pierpaolo452/Dynamic-DC-eLoad/README.md

# Dynamic DC eLoad
A DC electronic load with protections. It's a learning/developing project, so a lot of things are discrete just for learning to build it for example the Efuse is discrete
