pierpaolo452/Dynamic-DC-eLoad/Simulations/PID/PID.png

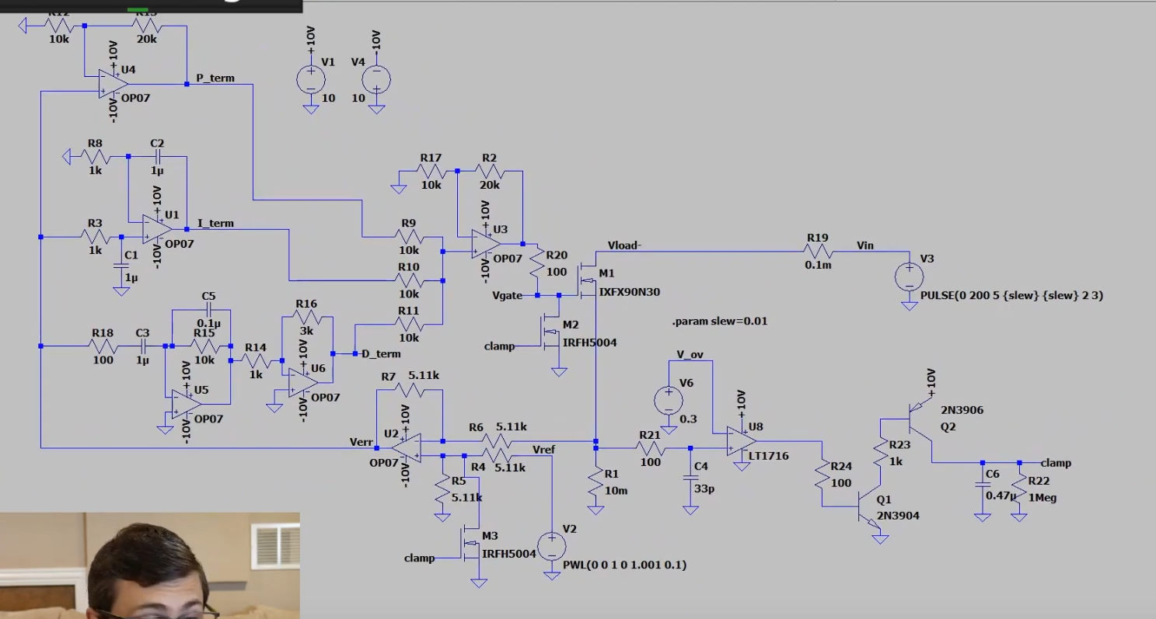
Simulations/PID/PID.png
