pierpaolo452/Dynamic-DC-eLoad/PCB/ADS131M04IPWR/ADS131M04IPWR.step

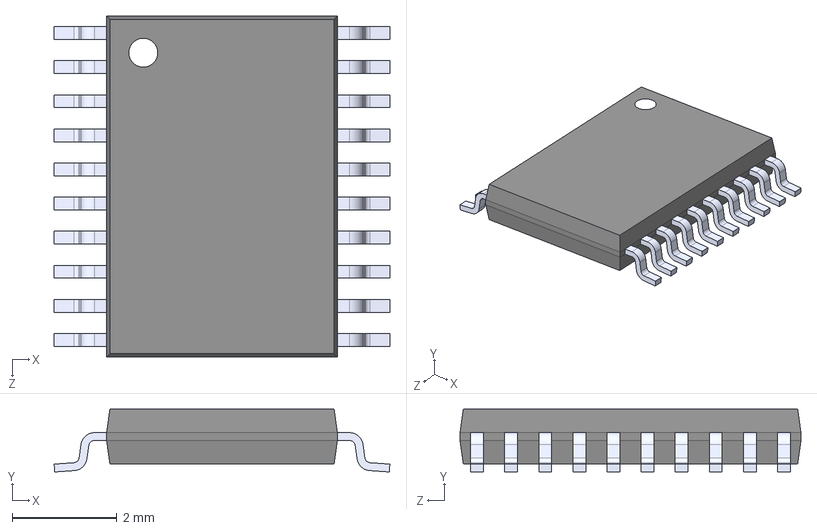
[picture p2: CAD file, 2025-09-29]
PCB/ADS131M04IPWR/ADS131M04IPWR.step
6.40 x 1.20 x 6.50 mm
