pierpaolo452/Dynamic-DC-eLoad/PCB/DAC8830IDR/DAC8830IDR.step

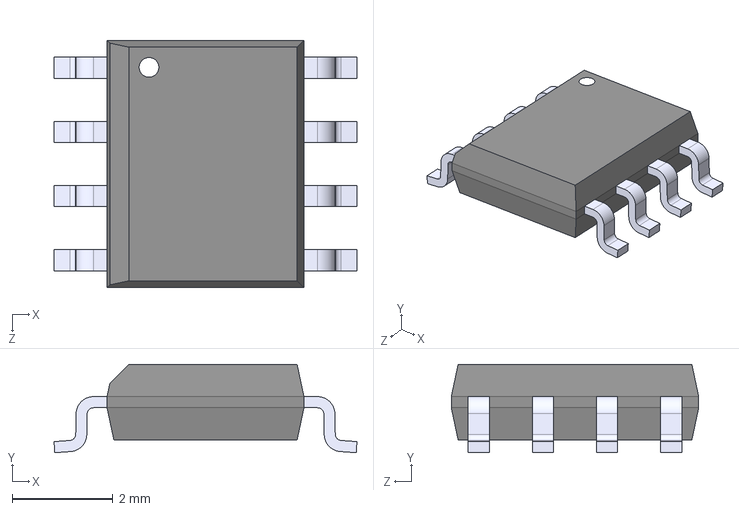
[picture p3: CAD file, 2025-09-29]
PCB/DAC8830IDR/DAC8830IDR.step
6.00 x 1.75 x 4.90 mm
