pierpaolo452/Dynamic-DC-eLoad/PCB/IRFP250N/IRFP250N.step

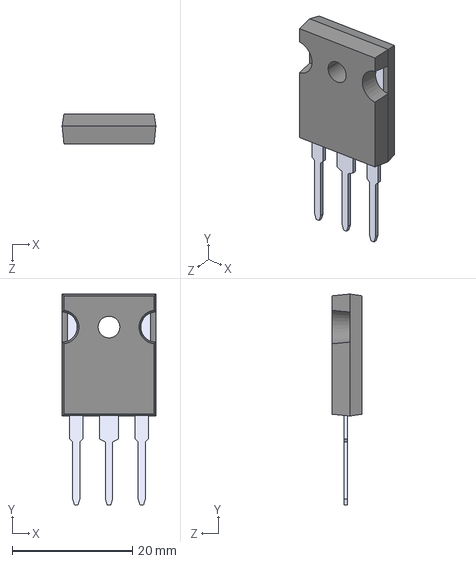
[picture p4: CAD file, 2025-09-29]
PCB/IRFP250N/IRFP250N.step
15.6 x 35.1 x 5.00 mm
