pierpaolo452/Dynamic-DC-eLoad/PCB/rotary encoder/PEC11R-4215F-S0024.step

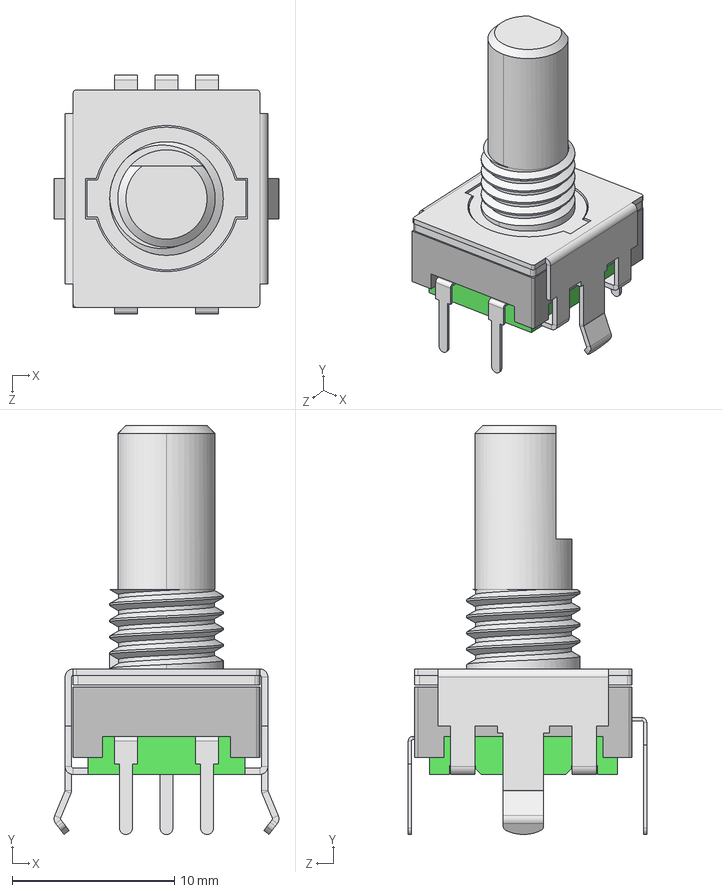
[picture p5: CAD file, 2025-09-29]
PCB/rotary encoder/PEC11R-4215F-S0024.step
13.9 x 25.2 x 14.7 mm
