pierpaolo452/Dynamic-DC-eLoad/PCB/TFT2.8/TFT_320x240_touch_r0.step

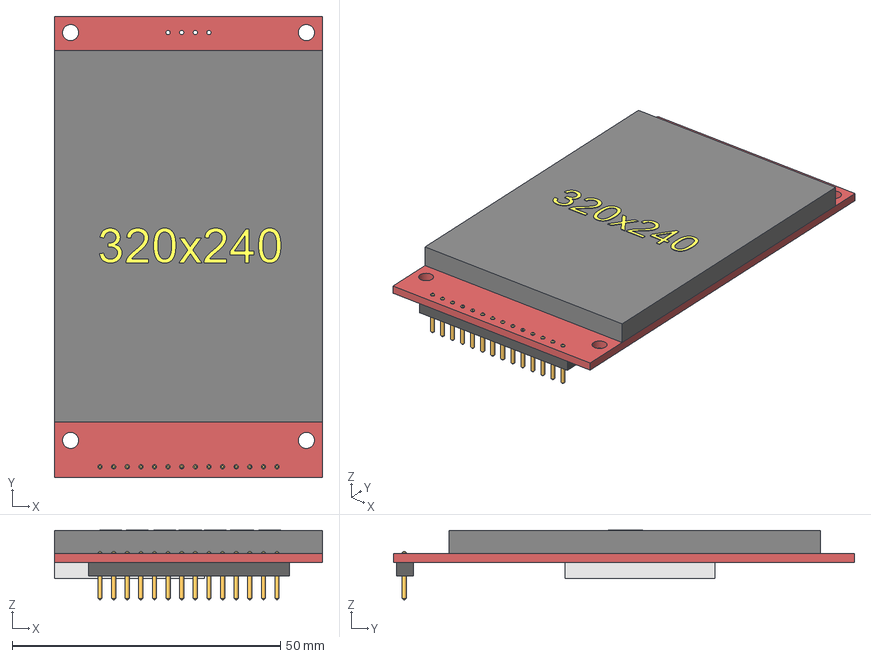
[picture p6: CAD file, 2025-09-29]
PCB/TFT2.8/TFT_320x240_touch_r0.step
50.0 x 86.0 x 13.1 mm
Body-header
Body-pins
Body-display
Body-sdcard
Body-board
