pierpaolo452/Dynamic-DC-eLoad/Simulations/test buffer/DCLoadbuff.asc

1stgPDB: npn; 2N3904
1stgPDR: res; {R1stg}
1stgPUB: pnp; 2N3906
1stgPUR: res; {R1stg}
2stgPDB: pnp; 2N3906
2stgPDR: res; {R2stg}
2stgPUB: npn; 2N3904
2stgPUR: res; {R2stg}
C1: cap; 500p
C2: cap; 500p
Q1: npn; 2N3904
Q2: pnp; 2N3906
RLoad1: res; {Rtest}
RLoad: res; {Rtest}
Rsafety1: res; {50.1-R2stg}
Rsafety: res; {50.1-R2stg}
V1: voltage; -5v
V2: voltage; 4; AC 1
V3: voltage; PULSE(-12 12 10u 1n 1n 50u 100u); AC 0
V4: voltage; 4
V5: voltage; -9
V7: voltage; 9
Named nets: 0, Vcc, -5V, IN, OUT, -Vcc, OUT2
.ic V(N003)=-5
.dc V3 0 9
.step dec param Rtest 10 1k 1
.param R1stg=10k R2stg=20 Rtest=100
.step dec param R1stg 100 1k 3
.ac dec 10 1m 100Meg
.step param R2stg list 1 5 10 20 50 100
.tran 0 100u 1u
