pierpaolo452/Dynamic-DC-eLoad/Simulations/test buffer/Draft1.asc

M1: nmos; 2N7002
Q1: npn; 2N2222
R1: res; 1k
R2: res; 10k
R3: res; 1k
R4: res; 10k
R5: res; 100
R6: res; 100
V1: voltage; 5
V2: voltage; {Ve}
V3: voltage; {Ve}
Named nets: 0
.op
.step param Ve -10 20
