pierpaolo452/Dynamic-DC-eLoad/Simulations/test buffer/Draft2.asc

M1: nmos; 2N7002
Q1: npn; 2N2222
R1: res; 25
R2: res; {R}
R3: res; 100k
R4: res; 10
R5: res; 25
R8: res; 10
V1: voltage; 5.5
V2: voltage; 3.3
V3: voltage; 5.5
V4: voltage; 3.3
Named nets: 0
.op
.step param R 1k 10k
