pierpaolo452/Dynamic-DC-eLoad/Simulations/test ringing/ringing.asc

B1: bv; V=(white(2e5*time)/3)
C1: cap; 400p
L1: ind; 1m; Rser=0
L2: ind; 7.5n
L3: ind; 3n
L4: ind; 4.5n
L5: ind; 600n
L6: ind; 100n
L7: ind; 100n
M1: pmos; IRF9640
MSB_Dac7: voltage; PWL(0 0 2000u 0 3000u {Vuut} 4000u 0)
R1: res; 100m
R2: res; 10
R3: res; 50
U1: irf9540n
V1: voltage; PULSE(12 -12 1u 10n 10n 10u 30u); Rser=1
V2: voltage; PULSE(0 {Vuut} 5000u 1n 1n 3000u 14000u)
V3: voltage; SINE(0 200m 100k)
V4: voltage; {Vuut}
Named nets: UUT, 0
.tran 20u
.param Vuut=12
