pierpaolo452/Dynamic-DC-eLoad/Simulations/clamp/clamp.asc

B1: bv; V=(white(2e8*time)/3)
C2: cap; 10p
D2: diode; 1N4148
Q7: npn; 2N3904
Q8: pnp; 2N3906
Q9: npn; 2N3904
Q10: pnp; 2N3906
Q11: npn; 2N3904
Q12: npn; 2N3904
R1: res; 10k
R2: res; 10Meg
R3: res; 10k
R9: res; {R1stg}
R10: res; {R1stg}
R11: res; {R2stg}
R12: res; {R2stg}
R13: res; 100
R14: res; 50m
R16: res; 10k
U1: lm393
U3: irfp064n
V1: voltage; PULSE(0 2 2u 10u 10u 20u 200u)
V3: voltage; 12
V4: voltage; -12
V6: voltage; 1
Named nets: 0, 12V, -12V
.param R1stg=500 R2stg=10 Rtest=100
.tran 100u
