pierpaolo452/Dynamic-DC-eLoad/Simulations/DCLoad2/DCLoad2-Pierp_PC2022.asc

B1: bv; V=(white(2e5*time)/3)
C1: cap; 10n
J1: njf; J112
L1: ind; {Luut}; Rser=0
LSB_Dac: voltage; {LSB}
M2: nmos; IRFZ44N
MSB_Dac: voltage; {MSB}
R1: res; {Ruut}
R2: res; {Rgain}
R3: res; 10
R4: res; 1k
R5: res; 1k
R8: res; 10
R11: res; 10k
Rfb: res; {Rfb}
Rout: res; {Rout}
Shunt2: res; 200m; pwr=5
U1: LM358_NS
U6: LM358_NS
V1: voltage; 12
V2: voltage; PULSE(0 {Vuut} 50u 1n 1n 300u 600u)
V3: voltage; SINE(0 200m 100k)
V4: voltage; {Vuut}
V5: voltage; PULSE(0 3.3 0 1n 1n 600u 1200u)
V6: voltage; PULSE(3.3 0 0 1n 1n 600u 1200u)
Named nets: 0, 12V, UUT, IN, CVCR, CVCRN
.param MSB=3 LSB=0
.dc MSB_Dac 0 3.3
.step param MSB 0 400m 50m
.param VUUT 5
.param Rgain=1.5k Rout=100m Rfb=100m Ruut=100m Luut=1u Rpot=.1
.dc temp 25 175
.tran 1.5m
.op
.step param rpot 0 0.4 0.05
.step param Ruut
