pierpaolo452/Dynamic-DC-eLoad/Simulations/DCLoad2/DCLoad2.asc

B1: bv; V=(white(2e5*time)/3)
C1: cap; 100p
C2: cap; 100p
C3: cap; 47µ
L1: ind; {Luut}; Rser=0
L2: ind; {Luut}; Rser=0
MainShunt: res; 10m; pwr=5
MSB_Dac2: voltage; PULSE(0 {MaxDAC} 2000u 1n 1n 4000u 15000u)
MSB_Dac3: voltage; PWL(0 0 6000u 0 7000u {MaxDAC} 8000u 0)
MSB_Dac7: voltage; PWL(0 0 2000u 0 3000u {Vuut} 4000u 0)
MSB_Dac: voltage; {MaxDAC}
Q1: npn; 2N3904
Q2: pnp; 2N3906
Q3: npn; 2N3904
Q4: pnp; 2N3906
R1: res; {Ruut}
R2: res; {Ruut}
R4: res; 100
R5: res; 100
R6: res; {Rstab}
R7: res; 5k
R8: res; 1k
R9: res; 5k
R10: res; 10
R11: res; 1k
R12: res; 10
R13: res; {Rstab}
R14: res; 100
R15: res; 100
R16: res; 1k
R18: res; 1k
R19: res; 100
R20: res; 100
R21: res; 2.5k
R22: res; 2.5k
R23: res; 100
Shunt1: res; 50m; pwr=5
Shunt2: res; 50m; pwr=5
U1: OP07
U2: irfp150n
U3: OP07
U4: TL072
U5: irfp150n
U6: OP07
U7: TL072
U8: OP07
V1: voltage; -5v
V2: voltage; PULSE(0 {Vuut} 5000u 1n 1n 3000u 14000u)
V3: voltage; SINE(0 200m 100k)
V4: voltage; {Vuut}
V5: voltage; PULSE(0 3.3 0 1n 1n 600u 1200u)
V6: voltage; PULSE(3.3 0 0 1n 1n 600u 1200u)
V7: voltage; 12
V8: voltage; 9
Named nets: 0, UUT, CVCR, CVCRN, 9V, 12V, 9v, -5V, DAC, INLOOP, Isense
.dc MSB_Dac 0 {MaxDAC}
.param VUUT=12
.param Ruut=10m Luut=10n Rstab=10k
.dc temp 25 175
.tran 0 9000u 50u
.op
.param MaxDAC=1
