pierpaolo452/Dynamic-DC-eLoad/Simulations/DCLoad4/Draft1.asc

R1: res; 8k
R2: res; 10k
R3: res; 10k
U1: irlz44n
U2: 2N7002
V1: voltage; 12
V2: voltage; PULSE(0 12 1u 1n 1n 100u 200u)
Named nets: 0
.tran 250u
