pierpaolo452/Dynamic-DC-eLoad/Simulations/DCLoad4/Draft2.asc

R1: res; {R}
R2: res; 10k
R3: res; 10k
R4: res; 10k
V1: voltage; 10
Named nets: 0
.op
.step dec param R 100 1Meg 3
