pierpaolo452/Dynamic-DC-eLoad/Simulations/differential amp/differential amp.asc

R1: res; {mc ({Rnf}, 0.01)}
R2: res; {mc ({Rpf}, 0.01)}
R3: res; {mc ({Rp}, 0.01)}
R4: res; {mc ({Rn}, 0.01)}
R5: res; {mc ({10k}, 0.01)}
R6: res; {mc ({900}, 0.01)}
R7: res; {mc ({190}, 0.01)}
R8: res; {mc ({1k}, 0.01)}
R9: res; {10k}
U1: OP07
U2: OP07
V1: voltage; 12
V2: voltage; -12V
V3: voltage; 0
Vcm: voltage; {Vcm}
Vin: voltage; {Vin}
Named nets: 0, 12V, -12V, OUT, OUT2, Vin, Vcm
.param GAIN=10 Rn=1k Rp=1k Rnf=GAIN*Rn Rpf=GAIN*Rp Vin=250m Vcm=200m
.dc Vin 0 250m  V3 0 2.5
.meas DC OFFSETMIN FIND V(out) AT 50m
.meas DC OFFMAX FIND V(out) AT 250m
.op
.meas DC OFFMAXpct FIND (V(out)-5)/5 AT 250m
.step param x 0 100 1
.meas DC OFFSETMINpct FIND V(out)-1 AT 50m
.meas DC OFFSETMIN2 FIND V(out2) AT 50m
.meas DC OFFMAX2 FIND V(out2) AT 250m
.meas DC OFFMAXpct2 FIND (V(out2)-5)/5 AT 250m
.meas DC OFFSETMINpct2 FIND V(out2)-1 AT 50m
