pierpaolo452/Dynamic-DC-eLoad/Simulations/LDO/LDO.asc

5k: res; {R}
C1: cap; {C2}
C2: cap; 1µ
C3: cap; 0.1µ
C4: cap; 10µ
D1: diode; 1N4002
I1: current; {Iload}; load
I2: current; {Iload}; load
Q1: npn; 2N3904
R1: res; 120
R2: res; 1k
R3: res; 10k
R4: res; 70k
U1: TL431
U2: LM317-TI
V1: voltage; 12
V3: voltage; SINE(0 500m 10k)
Named nets: 0, OUTP
.tran 2m
.step dec param R 500 1k 1000
.op
.step param C2 list 1f 10u 1
.param C2=10u R=700 Iload=1n
.step dec param Iload 100u 10m 2
