pierpaolo452/Dynamic-DC-eLoad/Simulations/negrail/negrail.asc

C1: cap; 1nf
C2: cap; 10p
C3: cap; {CFLY}; Rser=100m
C7: cap; 2µ; Rser=100m
D5: diode; BAV99HM
D6: diode; BAV99HM
I1: current; PULSE(1m 50m 2m 1m 1n 2m 10m); load
R4: res; {Rchill}
RA1: res; 10k
RB1: res; 100k
RLOAD1: res; {Rload}
U2: NE555
V1: voltage; PULSE(0 12 0 1n 1n {duty} 2u); Rser=100m
V2: voltage; 12
V4: voltage; SINE(0 500m 10k)
Named nets: 0
.tran 5m
.op
.step dec param Rload 100 10k 1
.param Rload=100 CFLY=1u Rchill=10 duty=1u
.step dec param CFLY 10n 10u 1
.step dec param Rchill 10m 10 1
.step dec param Cstab 100n 100u 1
.step param duty list 0.5u 1u 1.5u 1.9u 1.99u
.step param CFLY list 10n 100n 1u 10u
