pierpaolo452/Dynamic-DC-eLoad/Simulations/protection/OCP.asc

D1: zener; TFZV16B
D2: zener; KDZV16B
D3: zener; 1N749
D4: zener; TDZV16
D5: zener; TDZV22
E1: e; 20
M1: pmos; BSS84
M2: nmos; 2N7002
M3: pmos; BSS84
M4: pmos; BSS84
Q3: npn; 2N3904
R1: res; 100k
R2: res; 100k
R3: res; 0.1
R4: res; 5k
R5: res; 10k
R6: res; 4k
R7: res; 10k
R8: res; 40k
R9: res; 1k
R10: res; 1m
R11: res; 2k
R12: res; 20k
R13: res; 100k
R14: res; 1k
R15: res; 10k
R16: res; 1k
R17: res; 10k
U1: irf9540n
U2: irf9540n
U3: irfz44n
U4: LM339A_TI
U5: LM339A_TI
U6: UniversalOpAmp2; Ilimit=200m Rail=0 Vos=0
V1: voltage; PULSE({Vin} {-Vin} 6m 1u 1u 1m 100m)
V2: voltage; PULSE(0 3 1.1m 900u 1n 1n 100m)
V3: voltage; 9
V4: voltage; -12
V5: voltage; 2
V6: voltage; PULSE(0 3.3 0.3m 1u 1u 0.3m 100m)
V7: voltage; PULSE(0 12 8m 1n 1n 1m 100m)
V8: voltage; PULSE(0 3.3 2.3m 1u 1u 300u 100m)
V9: voltage; PULSE(3 0 11.5m 1n 1n 200u 100m)
V10: voltage; 3
V11: voltage; 5
V12: voltage; PULSE(0 3.3 9.3m 1u 1u 300u 100m)
V13: voltage; PULSE(0 1 11m 1n 1n 3m 100m)
V14: voltage; PULSE(0 1 4m 900u 1n 1n 100m)
V15: voltage; -5
V16: voltage; PULSE(0 10 13m 1u 1u 1m 100m)
V17: voltage; PULSE(0 3.3 12.3m 1u 1u 300u 100m)
Named nets: 0, 12V, -12V, OCP_EVENT, RST, OCP_override, 3V, 5V, -Vcc
.tran 15m
.step param UR list 1k 2k 3k 4k
.param UR=2k Ratio=7 DR=300
.step param Ratio list 7  10 13
.param Vin=20
2.5 Rst on
3.5 rst off
4 normal current ramp
5 normal current ramp off
6 -DUT
7 +DUT
8 Current step
11 current step (poco)
11.5 OCP override on
11.7 OCP override off
.step dec param Rtest 1 10k 1
