pierpaolo452/Dynamic-DC-eLoad/Simulations/spi trace/SPITrace.asc

C1: cap; 1p
C2: cap; 1p
C3: cap; 20p
L1: ind; 40n
R1: res; 1m
V1: voltage; PULSE(0 3 5n 1n 1n 10n 20n); Rser=30
Named nets: 0
.tran 50n
