pierpaolo452/Dynamic-DC-eLoad/Simulations/tl072/tl072.asc

B1: bv; V=(white(2e5*time)/3)
L1: ind; {Luut}; Rser=0
MSB_Dac2: voltage; PULSE(0 {MaxDAC} 500u 1n 1n 50ms 1s)
MSB_Dac3: voltage; PWL(0 0 6000u 0 7000u {MaxDAC} 8000u 0)
MSB_Dac7: voltage; PWL(0 0 2000u 0 3000u {Vuut} 4000u 0)
MSB_Dac: voltage; {MaxDAC}
Q1: npn; 2N3904
Q2: pnp; 2N3906
Q3: npn; 2N3904
Q4: pnp; 2N3906
Q5: npn; 2N3904
Q6: pnp; 2N3906
Q7: npn; 2N3904
Q8: pnp; 2N3906
Q9: npn; 2N3904
Q10: pnp; 2N3906
Q11: npn; 2N3904
Q12: pnp; 2N3906
R1: res; {Ruut}
R2: res; 5k
R3: res; 5k
R4: res; 5
R5: res; 5
R6: res; 5k
R7: res; 5k
R8: res; 5k
R9: res; 5k
R10: res; 5k
R11: res; 5k
R12: res; 5
R13: res; 5
R14: res; 1k
R15: res; 1k
R16: res; 10k
R17: res; 10k
R18: res; 5k
R19: res; 5k
R20: res; 5
R21: res; 5
R22: res; 1k
R23: res; 1k
R24: res; 1k
R25: res; 1k
Shunt1: res; 50m; pwr=5
Shunt2: res; 50m; pwr=5
Shunt3: res; 50m; pwr=5
U1: irfp150n
U2: irfp150n
U3: TL072
U4: OP07
U5: OP07
U7: irfp150n
V1: voltage; -12v
V2: voltage; PULSE(0 {Vuut} 5000u 1n 1n 3000u 14000u)
V3: voltage; SINE(0 200m 100k)
V4: voltage; {Vuut}
V7: voltage; 12
Named nets: 0, UUT, 12V, -12V, DAC, 12, Verr
.dc MSB_Dac 0 {MaxDAC}
.param VUUT=12
.param Ruut=10m Luut=10n Rstab=10k
.dc temp 25 175
.tran 0 100ms 50u
.op
.param MaxDAC=250m
.options gmin=1e-10
.options abstol=1e-10
.options reltol=0.003
.options cshunt=1e-15
