pierpaolo452/Dynamic-DC-eLoad/Simulations/tl43/tl431.asc

R1: res; 500
U1: TL431
V2: voltage; 3.3
V4: voltage; 0
Named nets: 0
.dc V2 0 9
