pierpaolo452/Dynamic-DC-eLoad/Simulations/protection/buffer/buffer.asc

D1: zener; KDZV16B
D2: zener; KDZV16B
M1: nmos; 2N7002
M4: pmos; Si1013
M5: nmos; 2N7002
Q1: npn
Q2: pnp
R1: res; {Ratio*DR}
R2: res; {DR}
R3: res; 1
U1: irf9540n
V1: voltage; 30
V2: voltage; PULSE(12 0 0 1n 1n 5m 10m)
Named nets: 0
.tran 10m
.param Ratio=10 DR=1k
.step param DR list 100 500 1k
