pierpaolo452/Dynamic-DC-eLoad/Simulations/protection/driverMAX/drivevrMAX.asc

C1: cap; 1µ
D1: zener; KDZV16B
R1: res; 51k
R2: res; 10
U1: LTC7062
U2: irfz44n
V1: voltage; 12
V2: voltage; 30
V3: voltage; PULSE(0 12 1m 1n 1n 4m 100m)
Named nets: 12V, 0
.tran 10m
