pierpaolo452/Dynamic-DC-eLoad/Simulations/protection/NMOS OCP/OCP.asc

D3: zener; 1N749
E1: e; 20
Q1: npn; 2N3904
Q2: npn; 2N3904
Q3: npn; 2N3904
Q4: npn; 2N3904
R1: res; 1k
R3: res; 0.1
R4: res; 20k
R5: res; 10k
R6: res; 2k
R7: res; 10k
R8: res; 10k
R9: res; 1k
R10: res; 1k
R12: res; 10k
R13: res; 1k
U3: irfz44n
U4: LM339A_TI
U5: LM339A_TI
U6: UniversalOpAmp2; Ilimit=200m Rail=0 Vos=0
U7: irfz44n
V1: voltage; PULSE({Vin} {-Vin} 6m 1u 1u 1m 100m)
V2: voltage; PULSE(0 3 1.1m 900u 900u 1m 10m)
V3: voltage; 12
V4: voltage; -12
V5: voltage; 2
V6: voltage; PULSE(0 3.3 0 1u 1u 1m 100m)
V7: voltage; PULSE(0 12 8m 1n 1n 1m 100m)
V8: voltage; PULSE(0 3.3 4m 1u 1u 1m 100m)
V9: voltage; 0
Named nets: 0, 12V, -12V, OCP_EVENT, RST, OCP_override
.tran 10m
.param Vin=12
