pierpaolo452/Dynamic-DC-eLoad/Simulations/protection/OCP2/OCP.asc

D1: zener; TDZV16
D2: zener; TFZV16B
E1: e; 20
M1: pmos; BSS84
M2: nmos; 2N7002
R1: res; 100k
R2: res; 100k
R3: res; 0.1
R4: res; {Rtest}
R5: res; 100k
R6: res; 1k
U1: irf9540n
U3: irfz44n
U6: UniversalOpAmp2; Ilimit=200m Rail=0 Vos=0
V1: voltage; 30
V2: voltage; PULSE(0 3 1.1m 900u 900u 1m 10m)
V3: voltage; PULSE(-12 5 0 1n 1n 2.5m 5m)
V4: voltage; 12
V5: voltage; -12
V6: voltage; 5
V7: voltage; PULSE(0 12 6m 1n 1n 3m 100m)
Named nets: 0, -12V, 12V, 5V
.tran 10m
.step param Rtest list 1k 10k 100k
.param Rtest 10k
