pierpaolo452/Dynamic-DC-eLoad/(list of files, drawings)

Other design files:
PCB/freerouting.dsn
PCB/temp-freerouting.dsn
