pierpaolo452/Dynamic-DC-eLoad/PCB/DCLoad4.kicad_pcb

## KiCad design PCB/DCLoad4.kicad_pcb (2025-09-29)

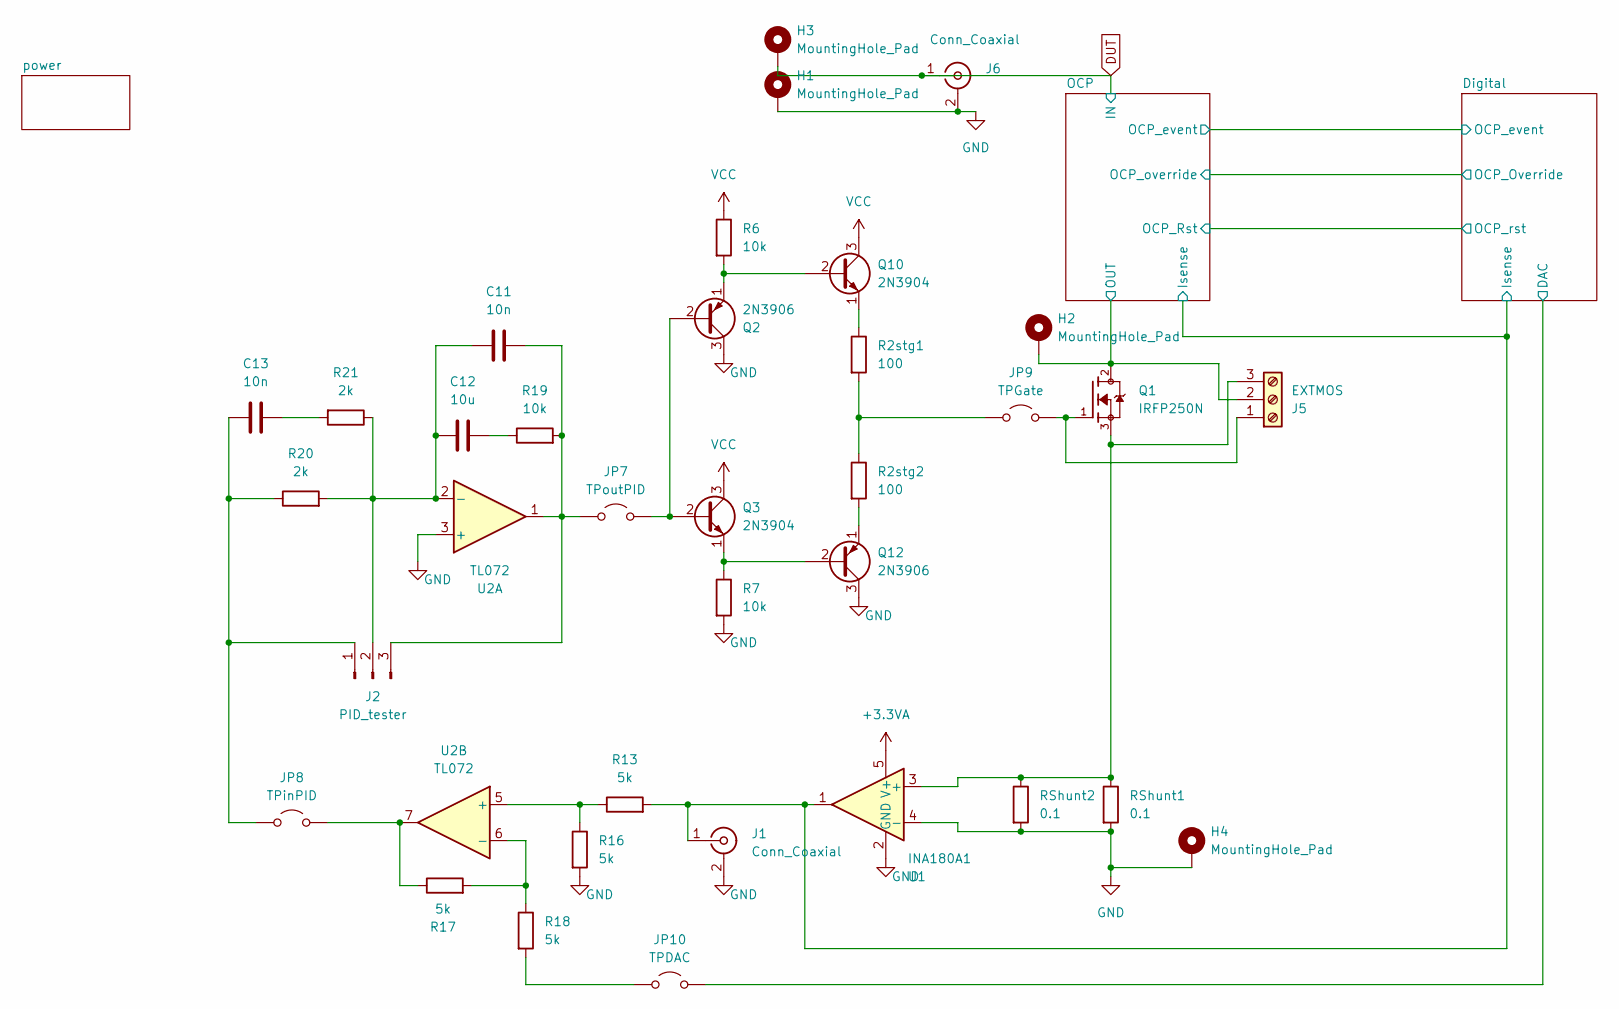
[picture p7: schematic DCLoad4.kicad_sch]

Parts:
C11, C13: 10n; C_0805_2012Metric_Pad1.18x1.45mm_HandSolder
C12: 10u; C_0805_2012Metric_Pad1.18x1.45mm_HandSolder
H1, H2, H3, H4: MountingHole_Pad; MountingHole_3.7mm_Pad_Via
J1, J6: Conn_Coaxial; BNC_Amphenol_B6252HB-NPP3G-50_Horizontal
J2: PID_tester; PinSocket_1x03_P2.54mm_Vertical
J5: EXTMOS; TerminalBlock_Phoenix_MKDS-1,5-3-5.08_1x03_P5.08mm_Horizont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
JP7: TPoutPID; PinSocket_1x02_P2.54mm_Vertical
JP8: TPinPID; PinSocket_1x02_P2.54mm_Vertical
JP9: TPGate; PinSocket_1x02_P2.54mm_Vertical
JP10: TPDAC; PinSocket_1x02_P2.54mm_Vertical
Q1: IRFP250N; TO-247-3_Vertical
Q2: 2N3906; SOT-23_Handsoldering
Q3: 2N3904; SOT-23_Handsoldering
Q10: 2N3904; TO-92
Q12: 2N3906; TO-92
R2stg1, R2stg2: 100; R_2512_6332Metric_Pad1.40x3.35mm_HandSolder
R6, R7, R19: 10k; R_0805_2012Metric_Pad1.20x1.40mm_HandSolder
R13, R16, R17, R18: 5k; R_0805_2012Metric_Pad1.20x1.40mm_HandSolder
R20, R21: 2k; R_0805_2012Metric_Pad1.20x1.40mm_HandSolder
RShunt1, RShunt2: 0.1; R_2512_6332Metric_Pad1.40x3.35mm_HandSolder
U1: INA180A1; SOT-23-5_HandSoldering
U2: TL072; DIP-8_W7.62mm_Socket

Connections:
+3.3VA: U1.5 (V+); also elsewhere on the board
/Digital/DAC: JP10.2 (B); also elsewhere on the board
/Digital/Isense: J1.1 (In), R13.2, U1.1; also elsewhere on the board
/OCP/OUT: H2.1, J5.2, Q1.2; also elsewhere on the board
DUT: H3.1, J6.1 (In); also elsewhere on the board
GND: H1.1, H4.1, J1.2 (Ext), J6.2 (Ext), Q2.3 (C), Q12.3 (C), R7.2, R16.2, RShunt1.2, RShunt2.2, U1.2 (GND), U1.4 (-), U2.3 (+); also elsewhere on the board
unnamed: C12.2, R19.1
unnamed: C13.2, R21.2
unnamed: C13.1, J2.1, JP8.1 (A), R20.1
unnamed: C11.1, C12.1, J2.2, R20.2, R21.1, U2.2 (-)
unnamed: C11.2, J2.3, JP7.1 (A), R19.2, U2.1
unnamed: J5.1, JP9.2 (B), Q1.1
unnamed: J5.3, Q1.3, RShunt1.1, RShunt2.1, U1.3 (+)
unnamed: JP7.2 (B), Q2.2 (B), Q3.2 (B)
unnamed: JP8.2 (B), R17.1, U2.7
unnamed: JP9.1 (A), R2stg1.2, R2stg2.1
unnamed: JP10.1 (A), R18.2
unnamed: Q2.1 (E), Q10.2 (B), R6.2
unnamed: Q10.1 (E), R2stg1.1
unnamed: Q3.1 (E), Q12.2 (B), R7.1
unnamed: Q12.1 (E), R2stg2.2
unnamed: R13.1, R16.1, U2.5 (+)
unnamed: R17.2, R18.1, U2.6 (-)
VCC: Q3.3 (C), Q10.3 (C), R6.1; also elsewhere on the board

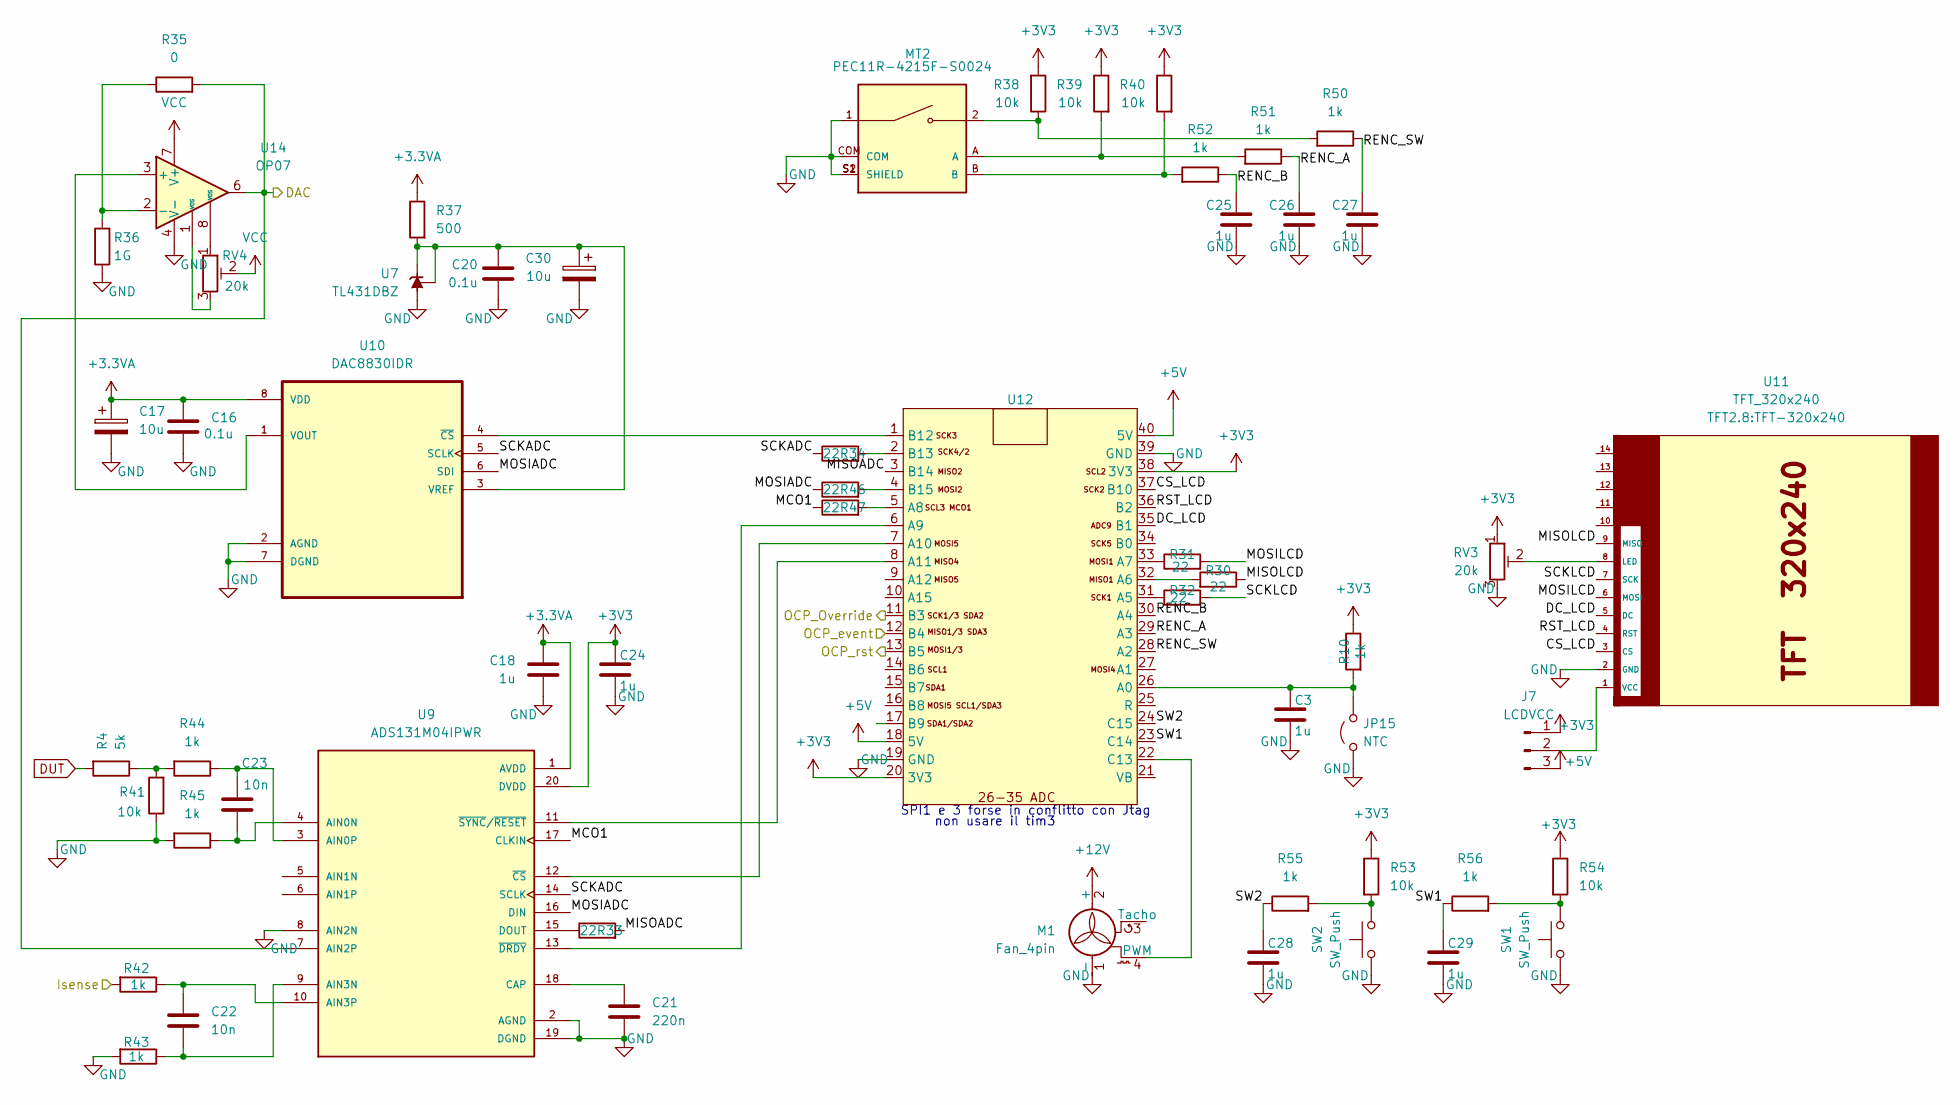
[picture p8: schematic Digital.kicad_sch]

Parts:
C3, C18, C24, C25, C26, C27, C28, C29: 1u; C_0805_2012Metric_Pad1.18x1.45mm_HandSolder
C16, C20: 0.1u; C_0805_2012Metric_Pad1.18x1.45mm_HandSolder
C17, C30: 10u; CP_EIA-3216-18_Kemet-A_Pad1.58x1.35mm_HandSolder
C21: 220n; C_0805_2012Metric_Pad1.18x1.45mm_HandSolder
C22, C23: 10n; C_0805_2012Metric_Pad1.18x1.45mm_HandSolder
J7: LCDVCC; PinSocket_1x03_P2.54mm_Vertical
JP15: NTC; PinSocket_1x02_P2.54mm_Vertical
M1: Fan_4pin; FanPinHeader_1x04_P2.54mm_Vertical
MT2: PEC11R-4215F-S0024; XDCR_PEC11R-4215F-S0024; PARTREV Rev. 09/19
R4: 5k; R_0805_2012Metric_Pad1.20x1.40mm_HandSolder
R10, R42, R43, R44, R45, R50, R51, R52, R55, R56: 1k; R_0805_2012Metric_Pad1.20x1.40mm_HandSolder
R30, R31, R32, R33, R34, R46, R47: 22; R_0805_2012Metric_Pad1.20x1.40mm_HandSolder
R35: 0; R_0805_2012Metric_Pad1.20x1.40mm_HandSolder
R36: 1G; R_0805_2012Metric_Pad1.20x1.40mm_HandSolder
R37: 500; R_0805_2012Metric_Pad1.20x1.40mm_HandSolder
R38, R39, R40, R41, R53, R54: 10k; R_0805_2012Metric_Pad1.20x1.40mm_HandSolder
RV3, RV4: 20k; Potentiometer_ACP_CA9-H5_Horizontal; LCSC C118929
SW1, SW2: SW_Push; Soft_Switch 8x8mm
U7: TL431DBZ; SOT-23_Handsoldering
U9: ADS131M04IPWR; TSSOP-20_4.4x6.5mm_P0.65mm; PARTREV D
U10: DAC8830IDR; SOIC127P599X175-8N
U11: TFT_320x240; TFT-320x240
U12: Blackpill_mia
U14: OP07; DIP-8_W7.62mm_Socket

Connections:
+3.3VA: C16.2, C17.1, C18.2, R37.1, U9.1 (AVDD), U10.8 (VDD); also elsewhere on the board
+3V3: C24.2, J7.1, R10.1, R38.2, R39.1, R40.1, R53.1, R54.1, RV3.1, U9.20 (DVDD), U12.20 (3V3), U12.38 (3V3); also elsewhere on the board
+5V: J7.3, U12.18 (5V), U12.40 (5V); also elsewhere on the board
+12V: M1.2 (+); also elsewhere on the board
/Digital/CS_LCD: U11.3 (CS), U12.37 (B10)
/Digital/DAC: R35.2, U9.7 (AIN2P), U14.6; also elsewhere on the board
/Digital/DC_LCD: U11.5 (DC), U12.35 (B1)
/Digital/Isense: R42.2; also elsewhere on the board
/Digital/MCO1: R47.1, U9.17 (CLKIN)
/Digital/MISOADC: R33.2, U12.3 (B14)
/Digital/MISOLCD: R30.1, U11.9 (MISO)
/Digital/MOSIADC: R46.1, U9.16 (DIN), U10.6 (SDI)
/Digital/MOSILCD: R31.2, U11.6 (MOSI)
/Digital/OCP_Override: U12.11 (B3); also elsewhere on the board
/Digital/OCP_event: U12.12 (B4); also elsewhere on the board
/Digital/OCP_rst: U12.13 (B5); also elsewhere on the board
/Digital/RENC_A: C26.2, R51.1, U12.29 (A3)
/Digital/RENC_B: C25.2, R52.1, U12.30 (A4)
/Digital/RENC_SW: C27.2, R50.1, U12.28 (A2)
/Digital/RST_LCD: U11.4 (RST), U12.36 (B2)
/Digital/SCKADC: R34.1, U9.14 (SCLK), U10.5 (SCLK)
/Digital/SCKLCD: R32.2, U11.7 (SCK)
/Digital/SW1: C29.2, R56.1, U12.23 (C14)
/Digital/SW2: C28.2, R55.1, U12.24 (C15)
DUT: R4.2; also elsewhere on the board
GND: C3.1, C16.1, C17.2, C18.1, C20.1, C21.2, C24.1, C25.1, C26.1, C27.1, C28.1, C29.1, C30.2, JP15.1 (A), M1.1 (-), MT2.1, MT2.COM, MT2.S1 (SHIELD), MT2.S2 (SHIELD), R36.1, R41.1, R43.2, R45.2, RV3.3, SW1.1, SW2.1, U7.3 (A), U9.2 (AGND), U9.8 (AIN2N), U9.19 (DGND), U10.2 (AGND), U10.7 (DGND), U11.2 (GND), U12.19 (GND), U12.39 (GND), U14.4 (V-); also elsewhere on the board
unnamed: J7.2, U11.1 (VCC)
unnamed: C3.2, JP15.2 (B), R10.2, U12.26 (A0)
unnamed: M1.4 (PWM), U12.22 (C13)
unnamed: MT2.2, R38.1, R50.2
unnamed: MT2.A, R39.2, R51.2
unnamed: MT2.B, R40.2, R52.2
unnamed: R4.1, R41.2, R44.2
unnamed: R53.2, R55.2, SW2.2
unnamed: R54.2, R56.2, SW1.2
unnamed: RV4.1, U14.8 (VOS)
unnamed: RV4.3, U14.1 (VOS)
unnamed: C23.2, R45.1, U9.4 (AIN0N)
unnamed: C23.1, R44.1, U9.3 (AIN0P)
unnamed: C22.2, R43.1, U9.9 (AIN3N)
unnamed: C22.1, R42.1, U9.10 (AIN3P)
unnamed: C21.1, U9.18 (CAP)
unnamed: R33.1, U9.15 (DOUT)
unnamed: U10.1 (VOUT), U14.3 (+)
unnamed: C20.2, C30.1, R37.2, U7.1 (K), U7.2 (REF), U10.3 (VREF)
unnamed: U10.4 (~CS), U12.1 (B12)
unnamed: RV3.2, U11.8 (LED)
unnamed: R32.1, U12.31 (A5)
unnamed: R30.2, U12.32 (A6)
unnamed: R31.1, U12.33 (A7)
unnamed: R47.2, U12.5 (A8)
unnamed: U9.13 (~DRDY), U12.6 (A9)
unnamed: U9.12 (~CS), U12.7 (A10)
unnamed: U9.11 (~SYNC/~RESET), U12.8 (A11)
unnamed: R34.2, U12.2 (B13)
unnamed: R46.2, U12.4 (B15)
unnamed: R35.1, R36.2, U14.2 (-)
VCC: RV4.2, U14.7 (V+); also elsewhere on the board

Notes on the sheet:
SPI1 e 3 forse in conflitto con Jtag
non usare il tim3

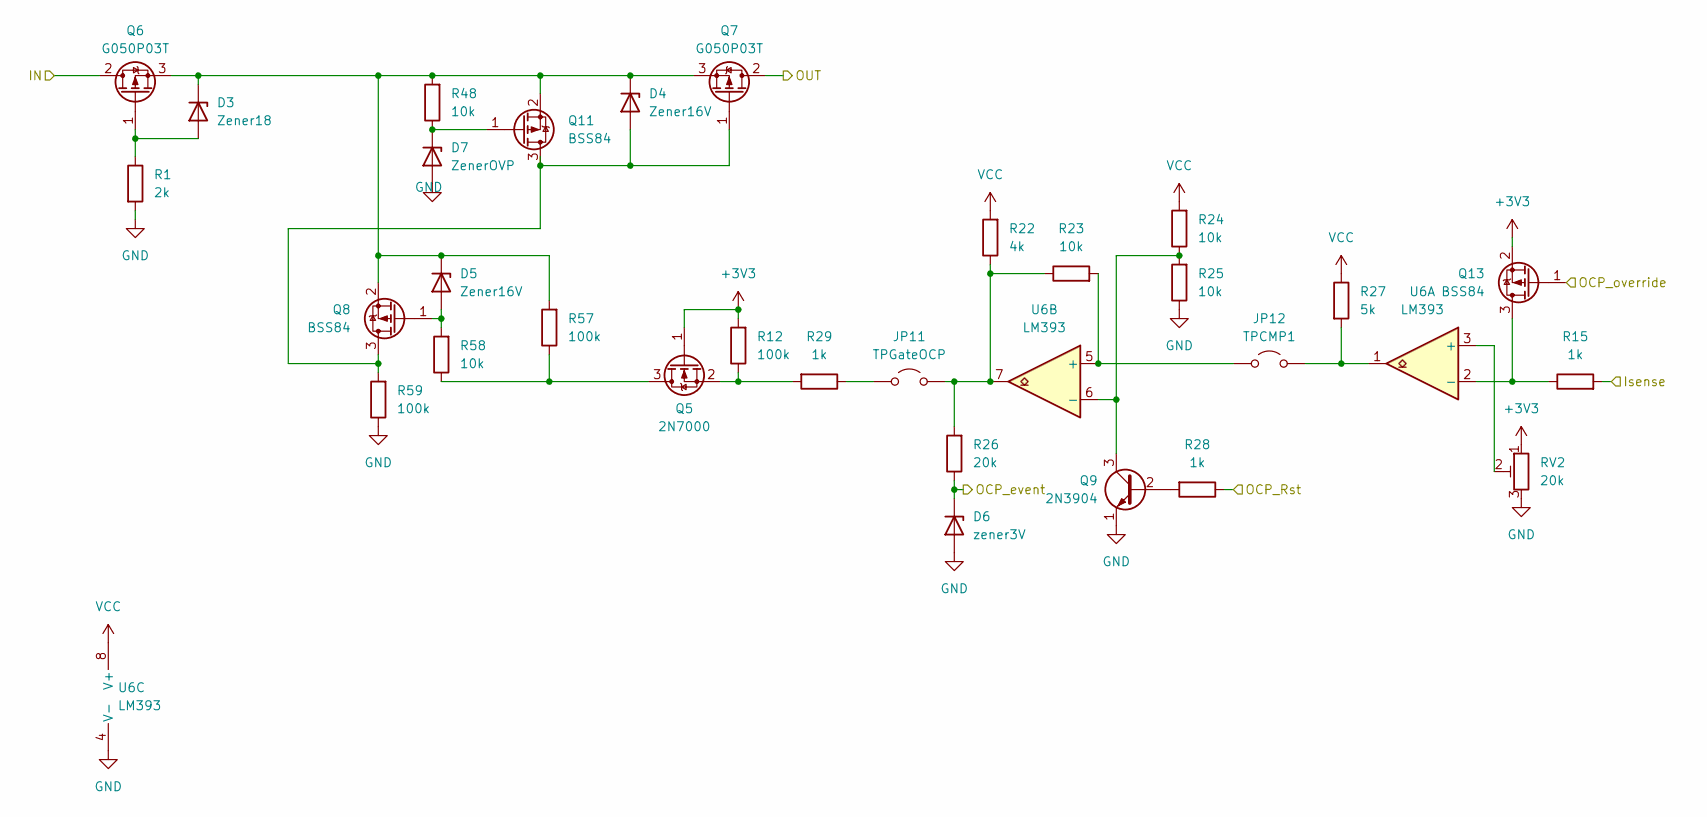
[picture p9: schematic OCP.kicad_sch]

Parts:
D3: Zener18; D_DO-35_SOD27_P7.62mm_Horizontal
D4, D5: Zener16V; D_DO-35_SOD27_P7.62mm_Horizontal
D6: zener3V; D_DO-35_SOD27_P7.62mm_Horizontal
D7: ZenerOVP; D_DO-35_SOD27_P7.62mm_Horizontal
JP11: TPGateOCP; PinSocket_1x02_P2.54mm_Vertical
JP12: TPCMP1; PinSocket_1x02_P2.54mm_Vertical
Q5: 2N7000; SOT-23_Handsoldering
Q6, Q7: G050P03T; TO-220-3_Vertical
Q8, Q11, Q13: BSS84; SOT-23_Handsoldering
Q9: 2N3904; SOT-23_Handsoldering
R1: 2k; R_0805_2012Metric_Pad1.20x1.40mm_HandSolder
R12, R57, R59: 100k; R_0805_2012Metric_Pad1.20x1.40mm_HandSolder
R15, R28, R29: 1k; R_0805_2012Metric_Pad1.20x1.40mm_HandSolder
R22: 4k; R_0805_2012Metric_Pad1.20x1.40mm_HandSolder
R23, R24, R25, R48, R58: 10k; R_0805_2012Metric_Pad1.20x1.40mm_HandSolder
R26: 20k; R_0805_2012Metric_Pad1.20x1.40mm_HandSolder
R27: 5k; R_0805_2012Metric_Pad1.20x1.40mm_HandSolder
RV2: 20k; Potentiometer_ACP_CA9-H5_Horizontal; LCSC C118929
U6: LM393; SOIC-8_3.9x4.9mm_P1.27mm

Connections:
+3V3: Q5.1 (G), Q13.2 (S), R12.2, RV2.1; also elsewhere on the board
/Digital/Isense: R15.2; also elsewhere on the board
/Digital/OCP_Override: Q13.1 (G); also elsewhere on the board
/Digital/OCP_event: D6.1 (K), R26.1; also elsewhere on the board
/Digital/OCP_rst: R28.1; also elsewhere on the board
/OCP/OUT: Q7.2 (D); also elsewhere on the board
DUT: Q6.2 (D); also elsewhere on the board
GND: D6.2 (A), D7.2 (A), Q9.1 (E), R1.2, R25.1, R59.1, RV2.3, U6.4 (V-); also elsewhere on the board
unnamed: D3.2 (A), Q6.1 (G), R1.1
unnamed: D3.1 (K), D4.1 (K), D5.1 (K), Q6.3 (S), Q7.3 (S), Q8.2 (S), Q11.2 (S), R48.2, R57.2
unnamed: D4.2 (A), Q7.1 (G), Q8.3 (D), Q11.3 (D), R59.2
unnamed: D5.2 (A), Q8.1 (G), R58.2
unnamed: D7.1 (K), Q11.1 (G), R48.1
unnamed: JP11.1 (A), R29.1
unnamed: JP11.2 (B), R22.1, R23.1, R26.2, U6.7
unnamed: JP12.1 (A), R23.2, U6.5 (+)
unnamed: JP12.2 (B), R27.2, U6.1
unnamed: Q5.3 (D), R57.1, R58.1
unnamed: Q5.2 (S), R12.1, R29.2
unnamed: Q9.2 (B), R28.2
unnamed: Q9.3 (C), R24.1, R25.2, U6.6 (-)
unnamed: Q13.3 (D), R15.1, U6.2 (-)
unnamed: RV2.2, U6.3 (+)
VCC: R22.2, R24.2, R27.1, U6.8 (V+); also elsewhere on the board

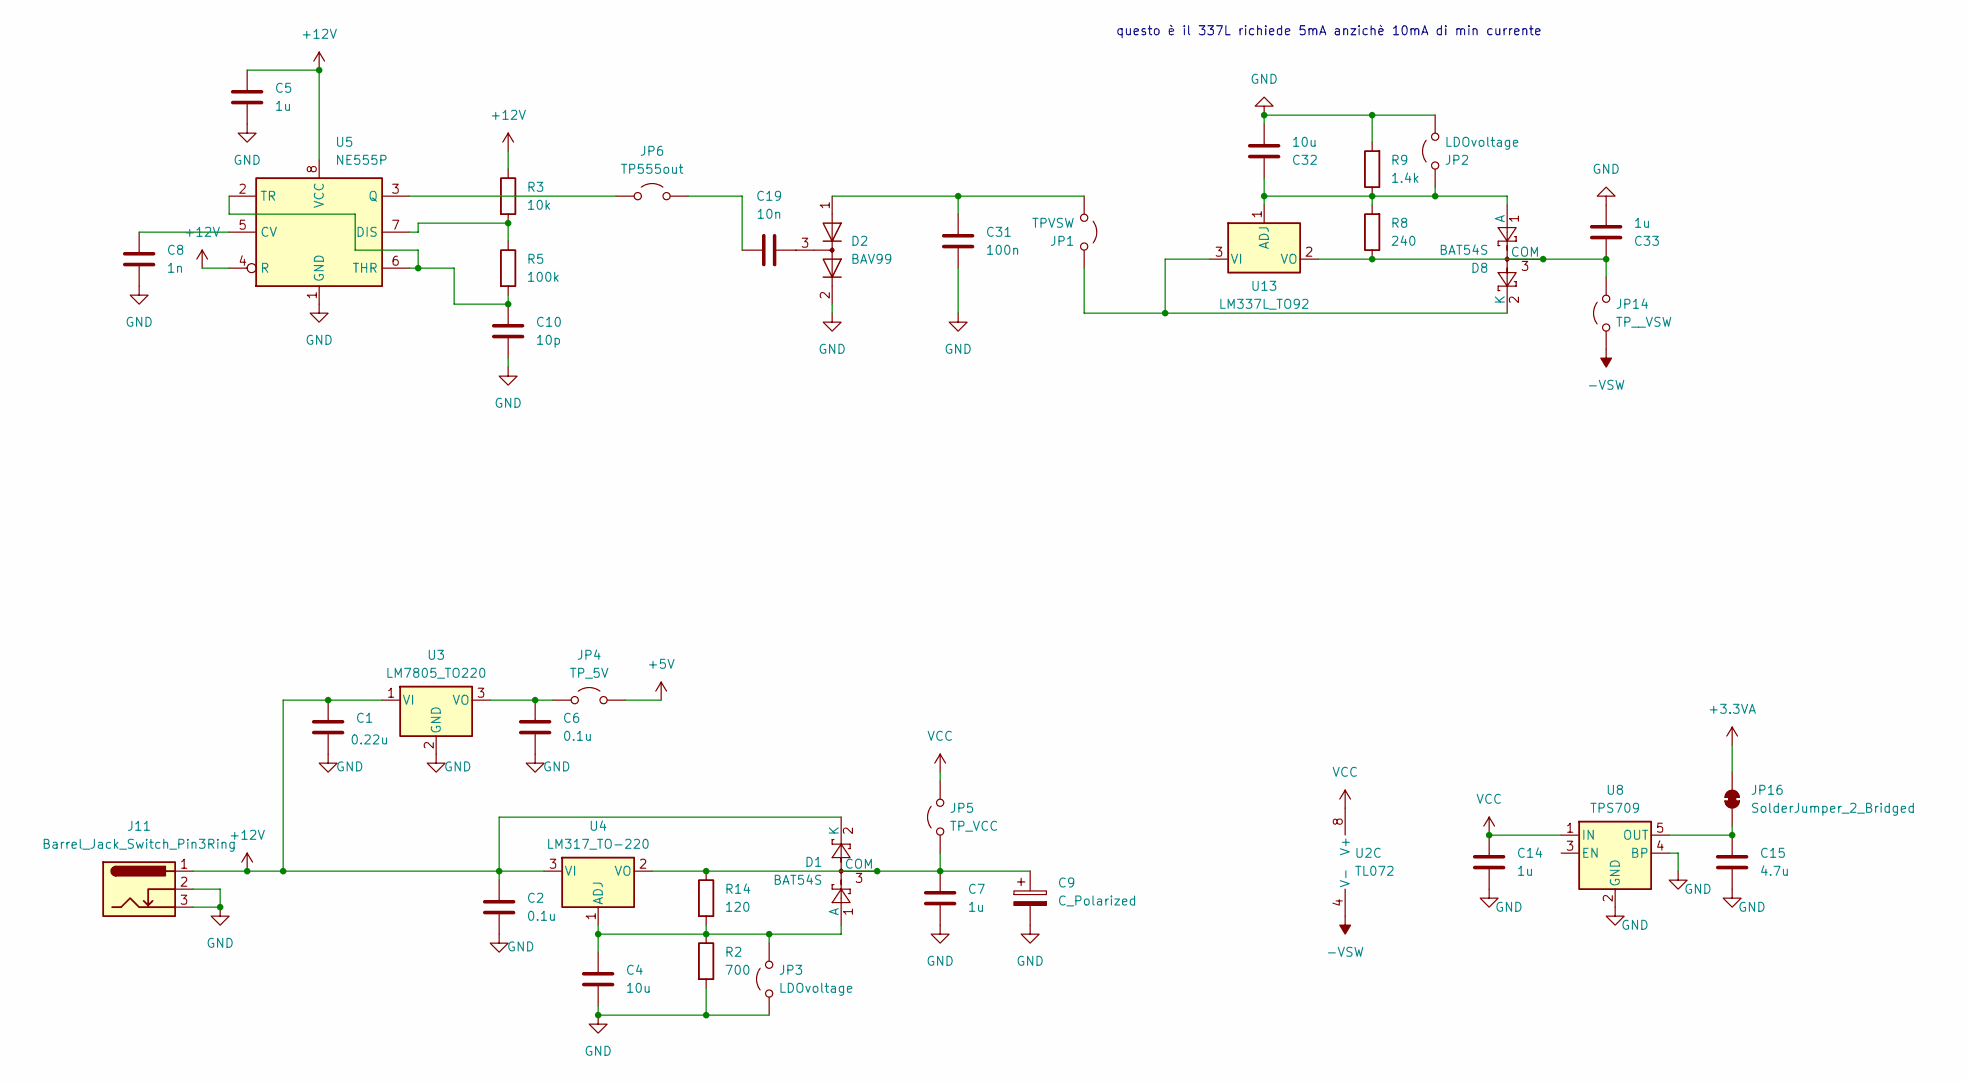
[picture p10: schematic power.kicad_sch]

Parts:
C1: 0.22u; C_0805_2012Metric_Pad1.18x1.45mm_HandSolder
C2, C6: 0.1u; C_0805_2012Metric_Pad1.18x1.45mm_HandSolder
C4, C32: 10u; C_0805_2012Metric_Pad1.18x1.45mm_HandSolder
C5, C7, C14, C33: 1u; C_0805_2012Metric_Pad1.18x1.45mm_HandSolder
C8: 1n; C_0805_2012Metric_Pad1.18x1.45mm_HandSolder
C9: C_Polarized; C_Radial_D5.0mm_H11.0mm_P2.00mm
C10: 10p; C_0805_2012Metric_Pad1.18x1.45mm_HandSolder
C15: 4.7u; C_0805_2012Metric_Pad1.18x1.45mm_HandSolder
C19: 10n; C_0805_2012Metric_Pad1.18x1.45mm_HandSolder
C31: 100n; C_0805_2012Metric_Pad1.18x1.45mm_HandSolder
D1, D8: BAT54S; SOT-23
D2: BAV99; SOT-23_Handsoldering
J11: Barrel_Jack_Switch_Pin3Ring; BarrelJack_Kycon_KLDX-0202-xC_Horizontal
JP1: TPVSW; PinSocket_1x02_P2.54mm_Vertical
JP2, JP3: LDOvoltage; PinSocket_1x02_P2.54mm_Vertical
JP4: TP_5V; PinSocket_1x02_P2.54mm_Vertical
JP5: TP_VCC; PinSocket_1x02_P2.54mm_Vertical
JP6: TP555out; PinSocket_1x02_P2.54mm_Vertical
JP14: TP__VSW; PinSocket_1x02_P2.54mm_Vertical
JP16: SolderJumper_2_Bridged; SolderJumper-2_P1.3mm_Bridged_RoundedPad1.0x1.5mm
R2: 700; R_0805_2012Metric_Pad1.20x1.40mm_HandSolder
R3: 10k; R_0805_2012Metric_Pad1.20x1.40mm_HandSolder
R5: 100k; R_0805_2012Metric_Pad1.20x1.40mm_HandSolder
R8: 240; R_0805_2012Metric_Pad1.20x1.40mm_HandSolder
R9: 1.4k; R_0805_2012Metric_Pad1.20x1.40mm_HandSolder
R14: 120; R_0805_2012Metric_Pad1.20x1.40mm_HandSolder
U2: TL072; DIP-8_W7.62mm_Socket
U3: LM7805_TO220; TO-220-3_Vertical
U4: LM317_TO-220; TO-220-3_Vertical
U5: NE555P; DIP-8_W7.62mm
U8: TPS709; SOT-23-5_HandSoldering
U13: LM337L_TO92; TO-92

Connections:
+3.3VA: JP16.2 (B); also elsewhere on the board
+5V: JP4.2 (B); also elsewhere on the board
+12V: C1.1, C2.1, C5.1, D1.2 (K), J11.1, R3.1, U3.1 (VI), U4.3 (VI), U5.4 (R), U5.8 (VCC); also elsewhere on the board
-VSW: JP14.2 (B), U2.4 (V-)
GND: C1.2, C2.2, C4.2, C5.2, C6.2, C7.2, C8.2, C9.2, C10.2, C14.2, C15.2, C31.2, C32.2, C33.2, D2.2 (A), J11.2, J11.3, JP2.1 (A), JP3.1 (A), R2.2, R9.2, U3.2 (GND), U5.1 (GND), U8.2 (GND), U8.4 (BP); also elsewhere on the board
unnamed: C19.2, D2.3 (K)
unnamed: C4.1, D1.1 (A), JP3.2 (B), R2.1, R14.2, U4.1 (ADJ)
unnamed: C7.1, C9.1, D1.3 (COM), JP5.1 (A), R14.1, U4.2 (VO)
unnamed: C32.1, D8.1 (A), JP2.2 (B), R8.2, R9.1, U13.1 (ADJ)
unnamed: C33.1, D8.3 (COM), JP14.1 (A), R8.1, U13.2 (VO)
unnamed: D8.2 (K), JP1.2 (B), U13.3 (VI)
unnamed: C31.1, D2.1 (K), JP1.1 (A)
unnamed: C6.1, JP4.1 (A), U3.3 (VO)
unnamed: JP6.1 (A), U5.3 (Q)
unnamed: C19.1, JP6.2 (B)
unnamed: C15.1, JP16.1 (A), U8.5 (OUT)
unnamed: C8.1, U5.5 (CV)
unnamed: R3.2, R5.1, U5.7 (DIS)
unnamed: C10.1, R5.2, U5.2 (TR), U5.6 (THR)
VCC: C14.1, JP5.2 (B), U2.8 (V+), U8.1 (IN); also elsewhere on the board

Notes on the sheet:
questo è il 337L richiede 5mA anzichè 10mA di min currente

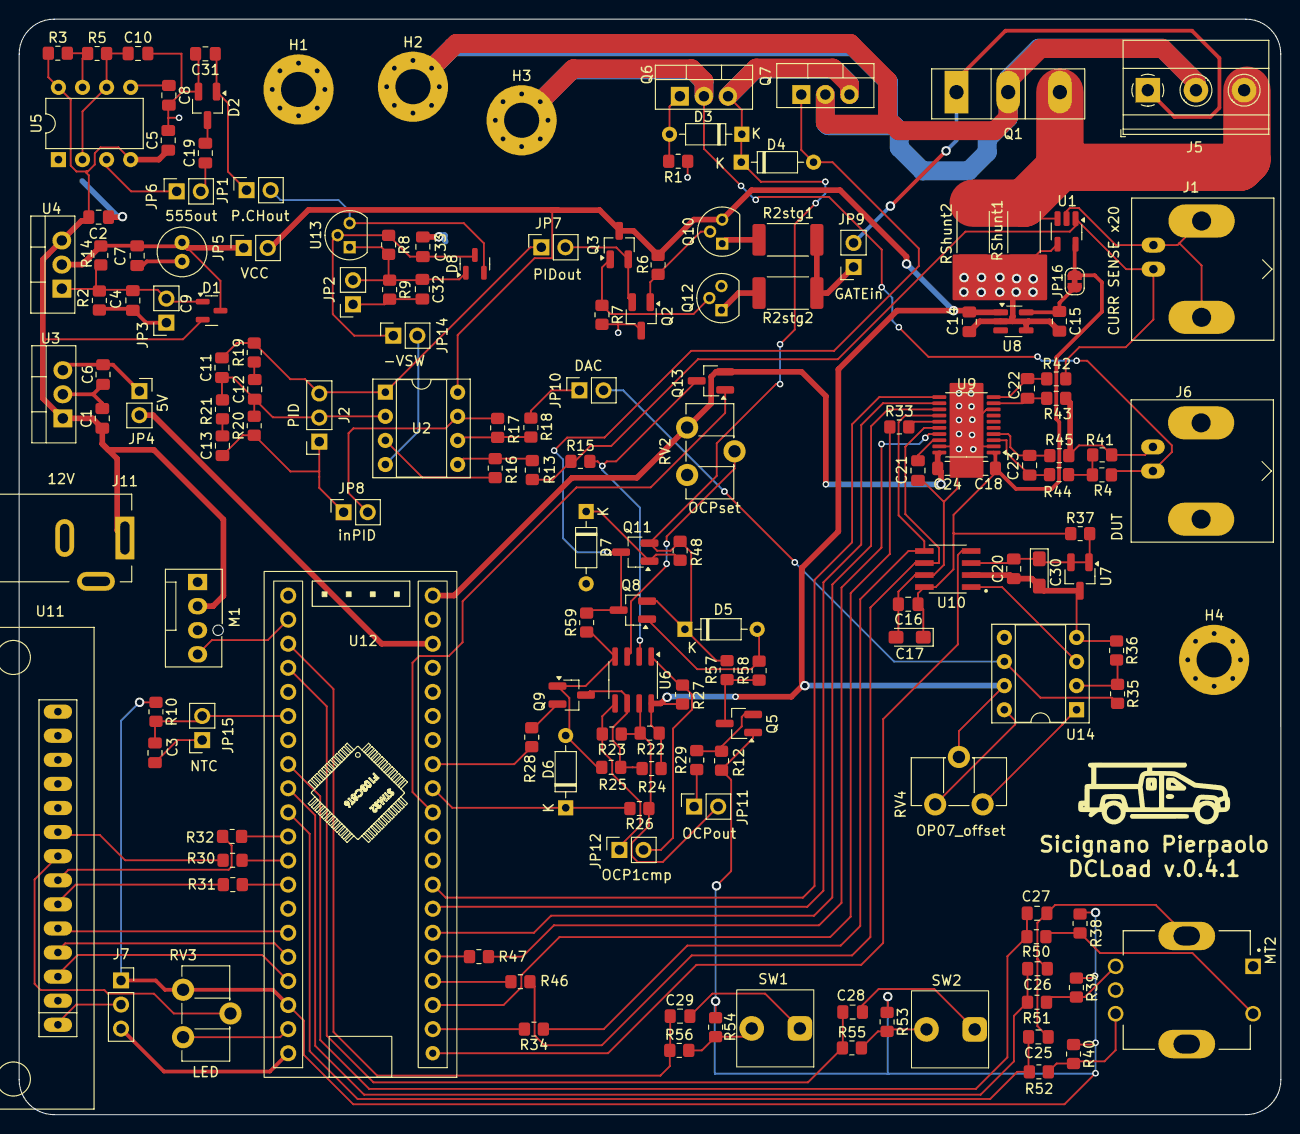
[picture p11: board DCLoad4.kicad_pcb from above]

Board: 2 copper layers, 133.0 x 115.5 mm, 160 parts (0 on the bottom side), 106 nets.
