pierpaolo452/Dynamic-DC-eLoad/(commit log)

2025-09-29 First up
    [dacRres.xlsx, temps.xlsx]
2025-09-29 PCB up
    add pcb
    [ADS131M04IPWR.step, DAC8830IDR.step, DCLoad4.csv, DCLoad4.kicad_pcb, DCLoad4.kicad_sch, Digital.kicad_sch, IRFP250N.step, OCP.kicad_sch]
